dfannin/arduino-vx8r-gps/img/ArduinoNanoFront.jpg

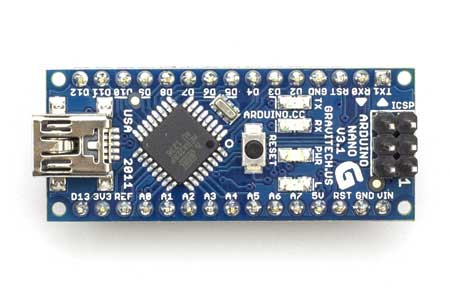
img/ArduinoNanoFront.jpg
