dfannin/arduino-vx8r-gps/img/vx8r-iso.jpg

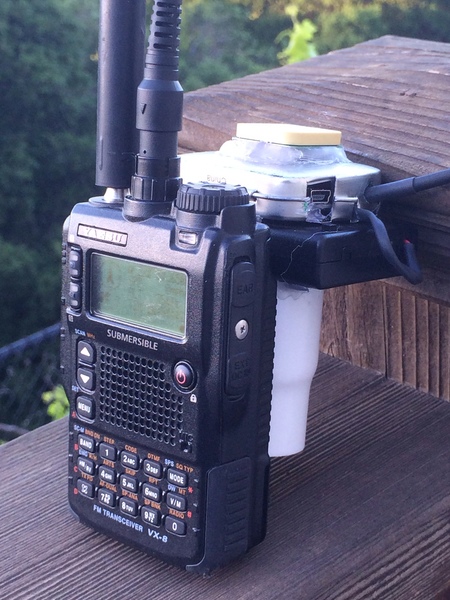
img/vx8r-iso.jpg
