dfannin/arduino-vx8r-gps/img/arduino-vx8r-gps-fig01.png

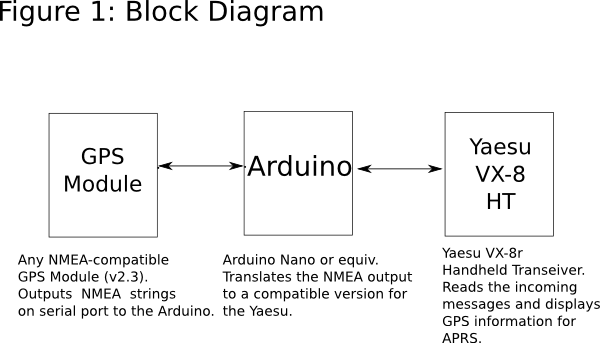
img/arduino-vx8r-gps-fig01.png
