dfannin/arduino-vx8r-gps/img/ublox-neo6m.jpg

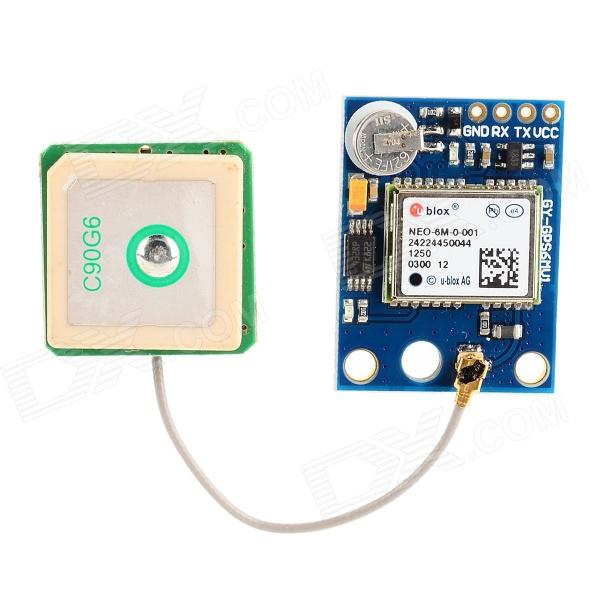
img/ublox-neo6m.jpg
