dfannin/arduino-vx8r-gps/img/vx8r-lcd.jpg

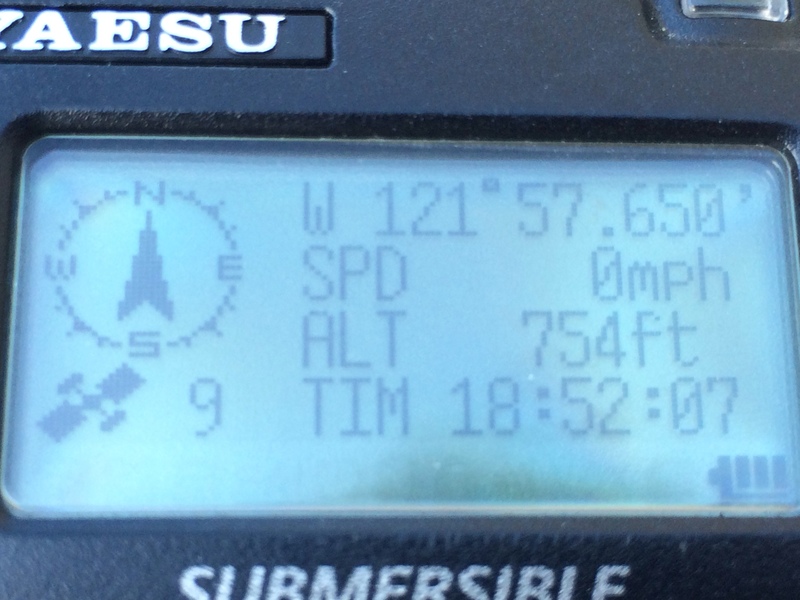
img/vx8r-lcd.jpg
