dfannin/arduino-vx8r-gps/img/YaesuGPSSchematic.png

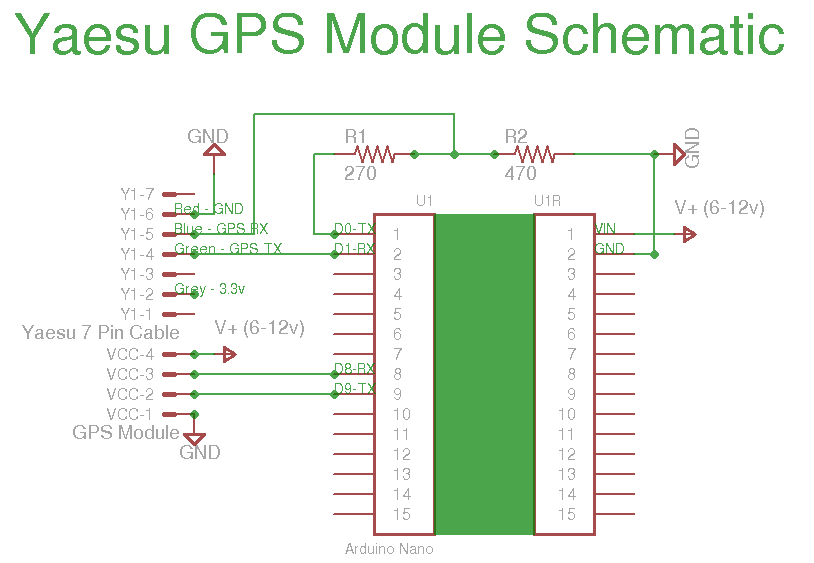
img/YaesuGPSSchematic.png
