dfannin/arduino-vx8r-gps/img/YaesuUSBCable.jpg

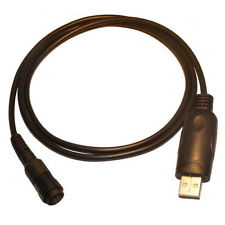
img/YaesuUSBCable.jpg
